amcguan/powermeter/Report/Images/mpu.jpg

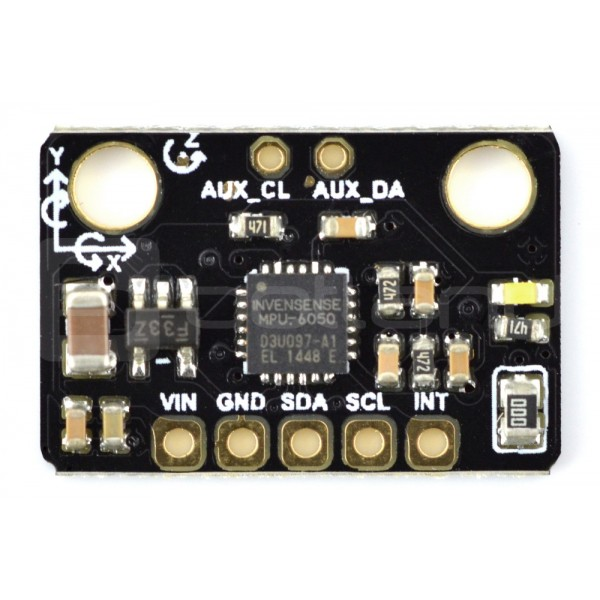
Report/Images/mpu.jpg
