amcguan/powermeter/Report/Images/L1Sketch.png

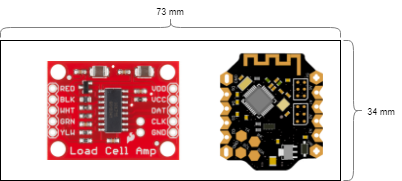
Report/Images/L1Sketch.png
