amcguan/powermeter/Report/outline.docx

Topics to Cover

1. Components
  a. Strain gauges
  b. Amplifier
  c. Arduino
  d. IMU
  e. Batteries
2. Calculations

Sections to include:

1. Overview
2. Design development – how I arrived at my current design
  a. Physical design
    i. Why crank mounted vs chainring or hub
    ii. Space considerations taken
  b. Hardware design
    i. Why I chose the components I did
3. Final Design
  a. Schematic
