amcguan/powermeter/Report/Images/crank arm 1-3.png

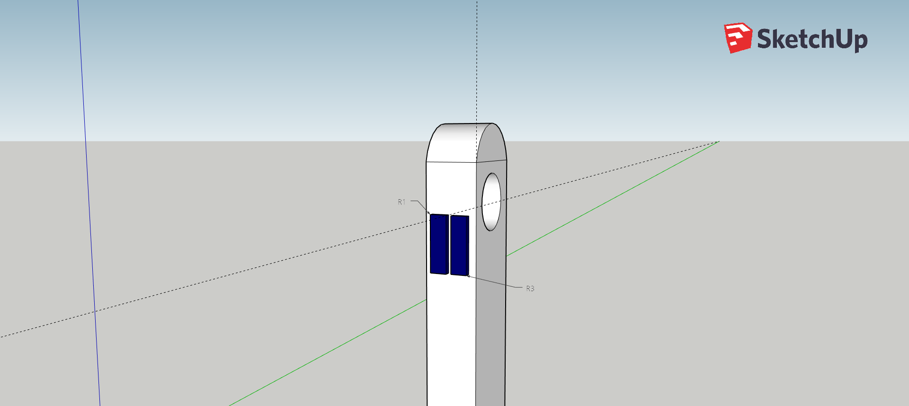
Report/Images/crank arm 1-3.png
