amcguan/powermeter/Report/Images/crank arm 2-3.png

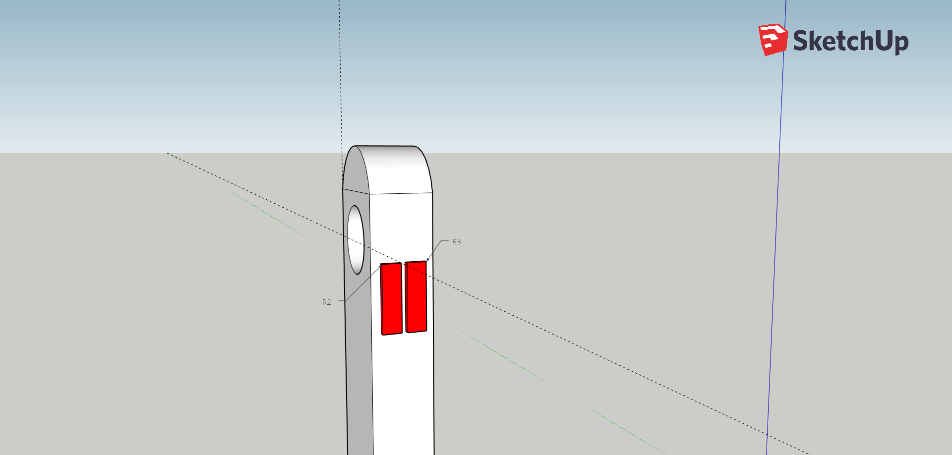
Report/Images/crank arm 2-3.png
