amcguan/powermeter/Report/Images/crank arm 2-4.png

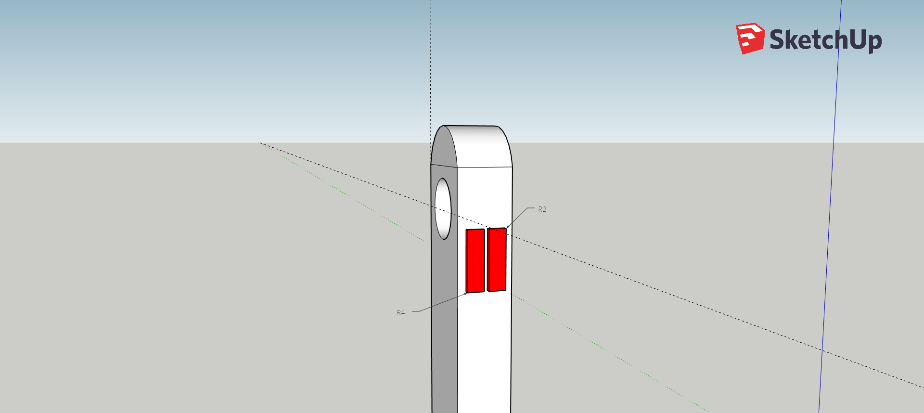
Report/Images/crank arm 2-4.png
