amcguan/powermeter/Report/Images/crank arm.png

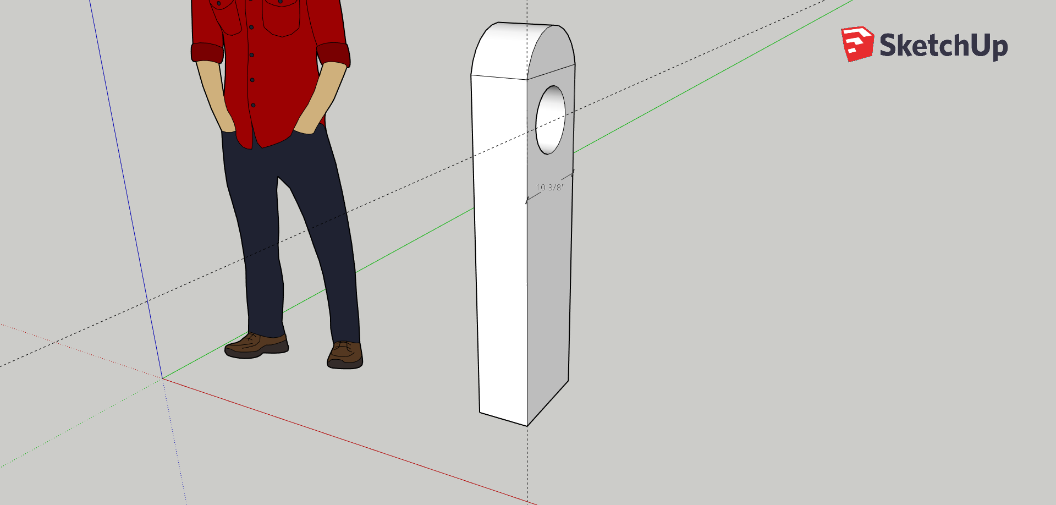
Report/Images/crank arm.png
