amcguan/powermeter/Report/Images/L1Solidworks.png

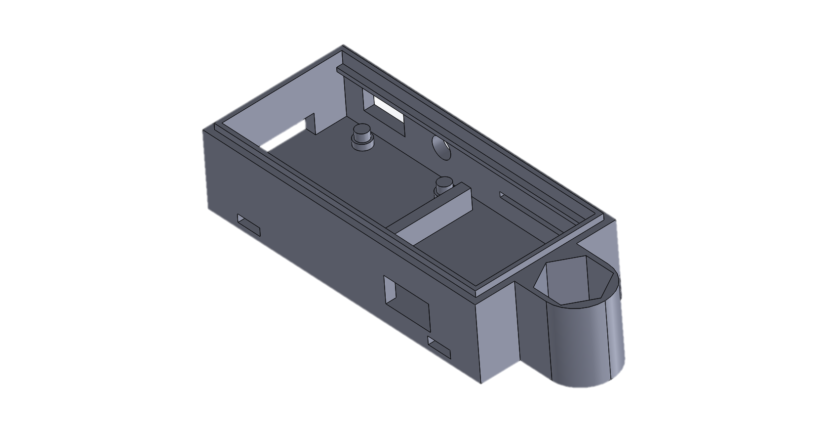
Report/Images/L1Solidworks.png
