amcguan/powermeter/Report/Images/L1SolidWorks_v2.png

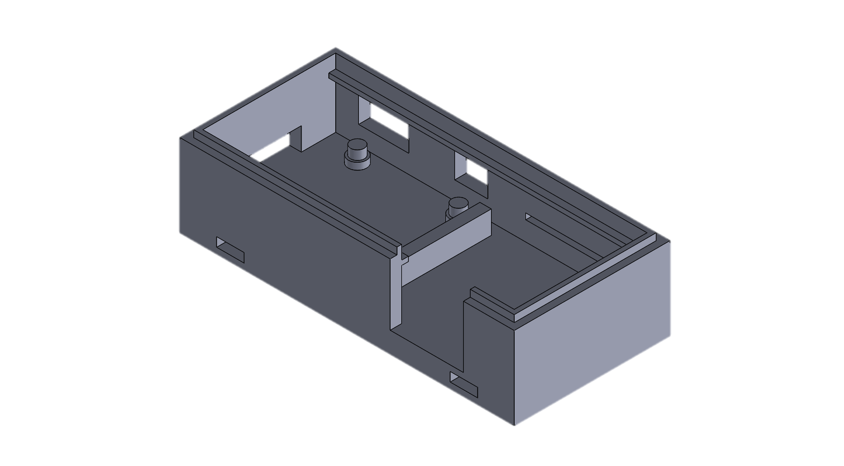
Report/Images/L1SolidWorks_v2.png
