amcguan/powermeter/Report/Images/L2SolidWorks.png

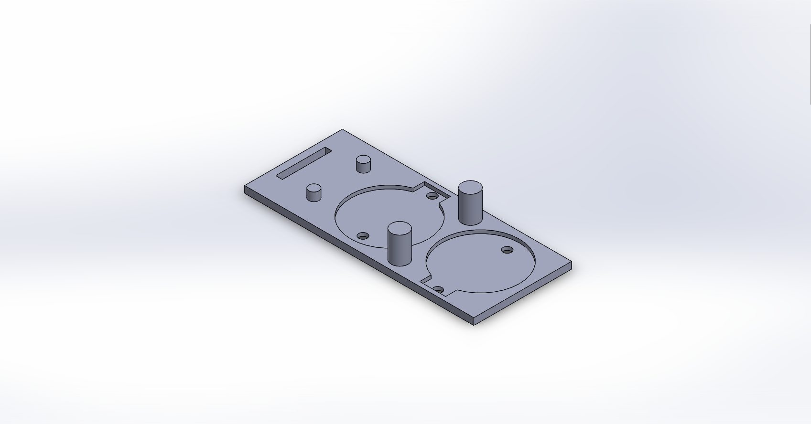
Report/Images/L2SolidWorks.png
