amcguan/powermeter/Report/Images/L2SolidWorks_v2.png

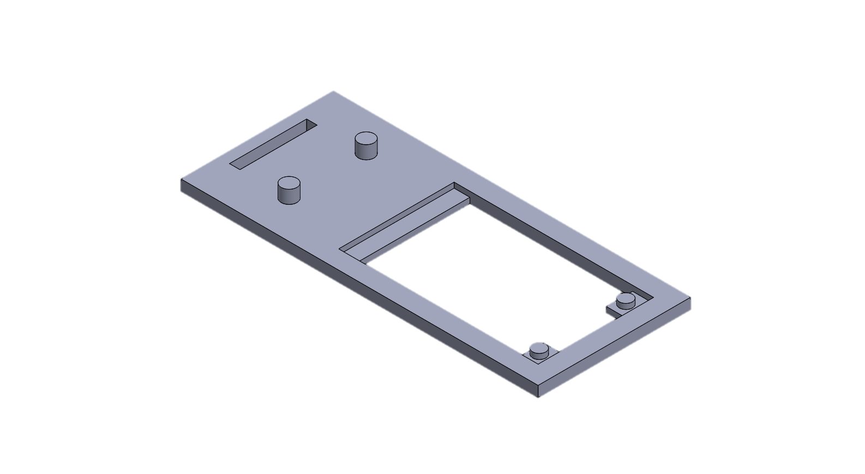
Report/Images/L2SolidWorks_v2.png
