amcguan/powermeter/SolidWorks/EnclosureComplete.SLDASM

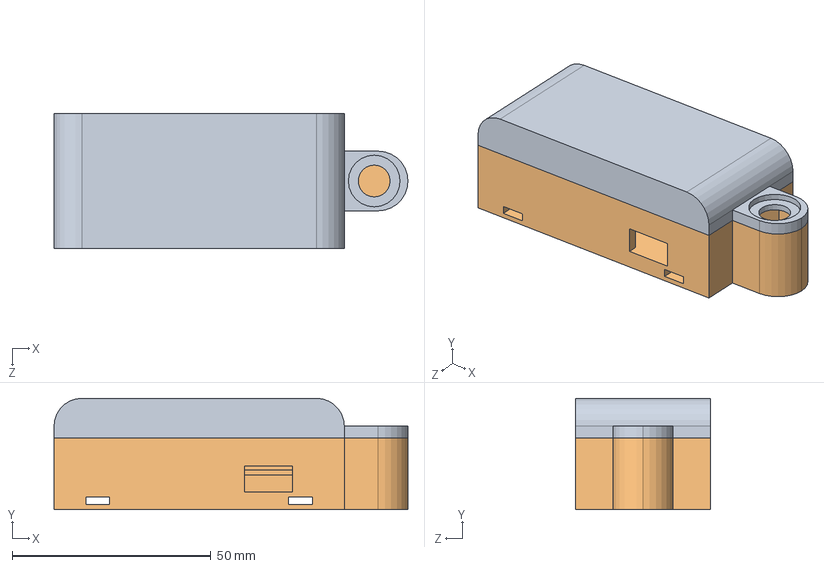
[picture p42: CAD file, 2018-06-10]
SolidWorks/EnclosureComplete.SLDASM
89.0 x 28.0 x 34.0 mm
EnclosureCap
EnclosureLevel1
EnclosureLevel2
