amcguan/powermeter/Report/Images/crank arm.stl

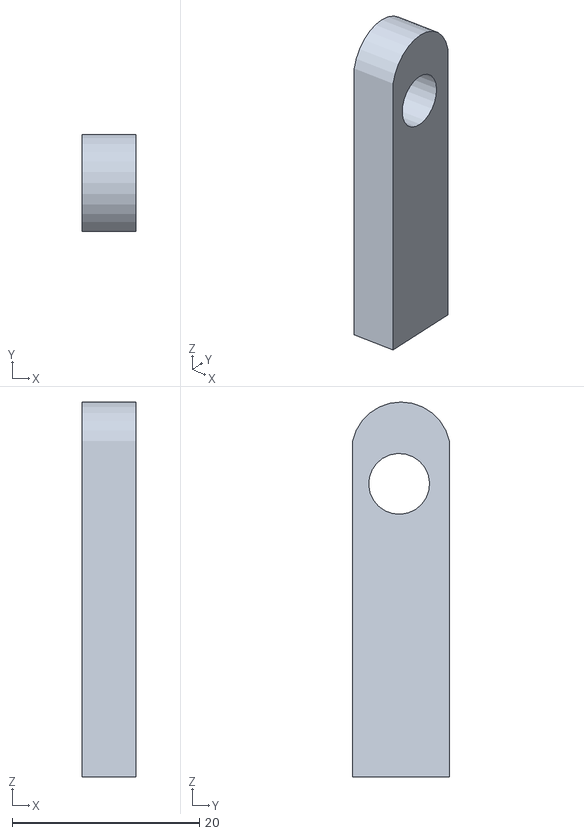
[picture p43: CAD file, 2018-06-10]
Report/Images/crank arm.stl
5.75 x 10.4 x 40.1
