amcguan/powermeter/SolidWorks/EnclosureLevel2_v2.SLDPRT

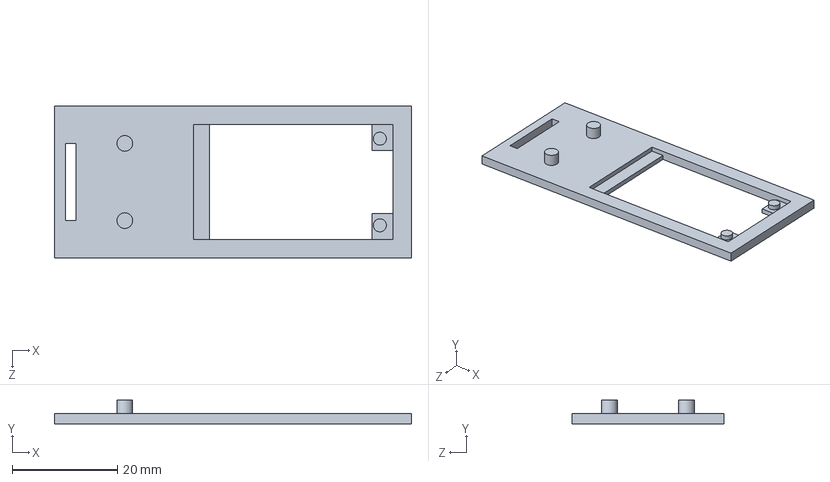
[picture p44: CAD file, 2018-06-10]
SolidWorks/EnclosureLevel2_v2.SLDPRT
68.0 x 4.50 x 29.0 mm
