amcguan/powermeter/SolidWorks/EnclosureLevel1_v2.SLDPRT

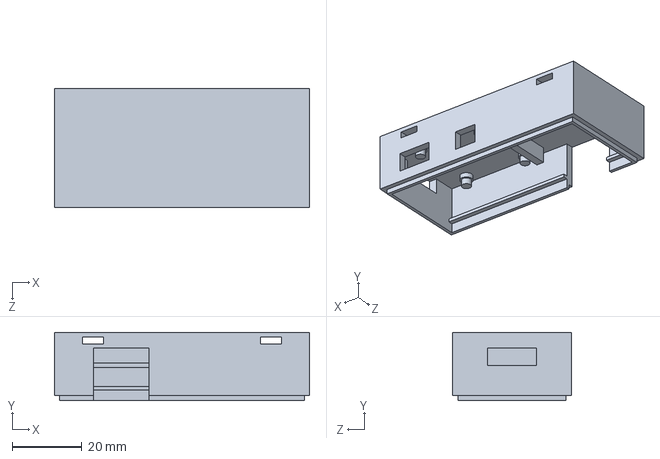
[picture p45: CAD file, 2018-06-10]
SolidWorks/EnclosureLevel1_v2.SLDPRT
73.0 x 19.5 x 34.0 mm
