amcguan/powermeter/SolidWorks/EnclosureCap.SLDPRT

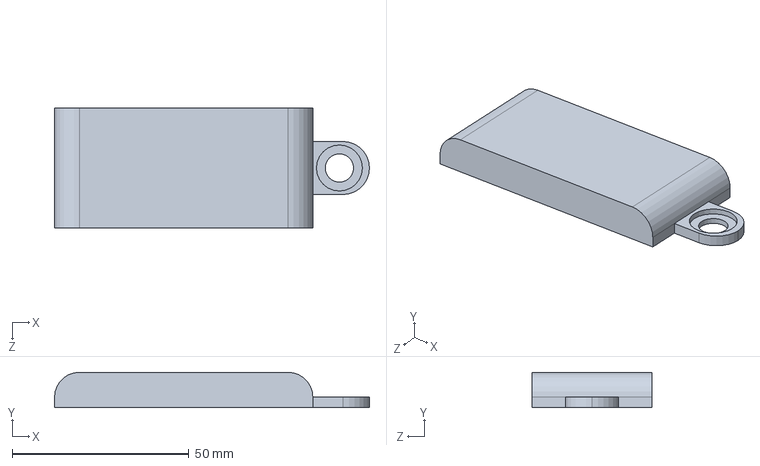
[picture p46: CAD file, 2018-06-10]
SolidWorks/EnclosureCap.SLDPRT
89.0 x 10.0 x 34.0 mm
