amcguan/powermeter/SolidWorks/EnclosureLevel2.SLDPRT

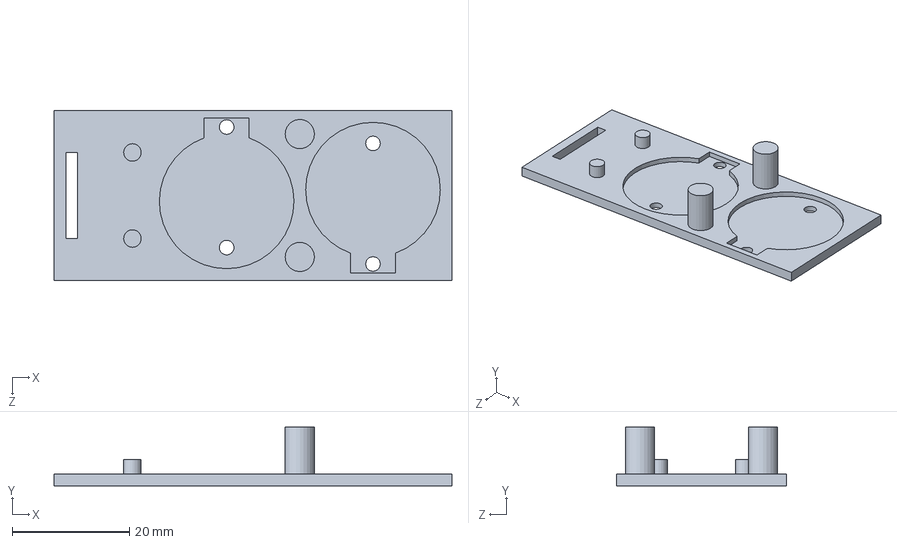
[picture p47: CAD file, 2018-06-10]
SolidWorks/EnclosureLevel2.SLDPRT
68.0 x 10.0 x 29.0 mm
