amcguan/powermeter/SolidWorks/EnclosureLevel1.SLDPRT

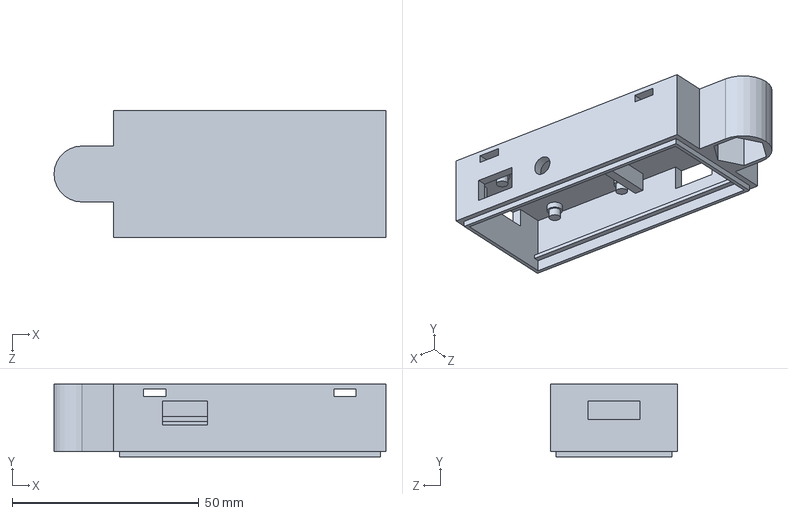
[picture p48: CAD file, 2018-06-10]
SolidWorks/EnclosureLevel1.SLDPRT
89.0 x 19.5 x 34.0 mm
