amcguan/powermeter/(list of files, cad)

Other CAD files:
SolidWorks/EnclosureCap.STL
SolidWorks/EnclosureLevel1.STL
SolidWorks/EnclosureLevel1_v2.STL
SolidWorks/EnclosureLevel2.STL
SolidWorks/EnclosureLevel2_v2.STL
